Orbital-CubeSat-McGill/lora-hab-test/media/jean-mance-test.png

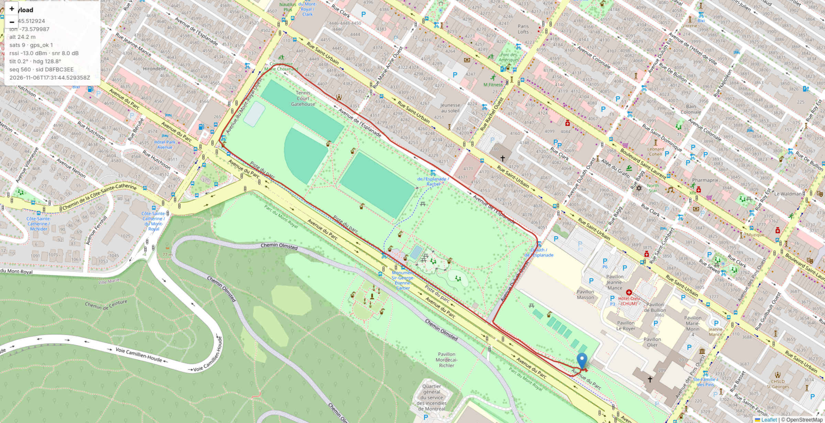
media/jean-mance-test.png
