Orbital-CubeSat-McGill/lora-hab-test/media/heltecv3-pinout.png

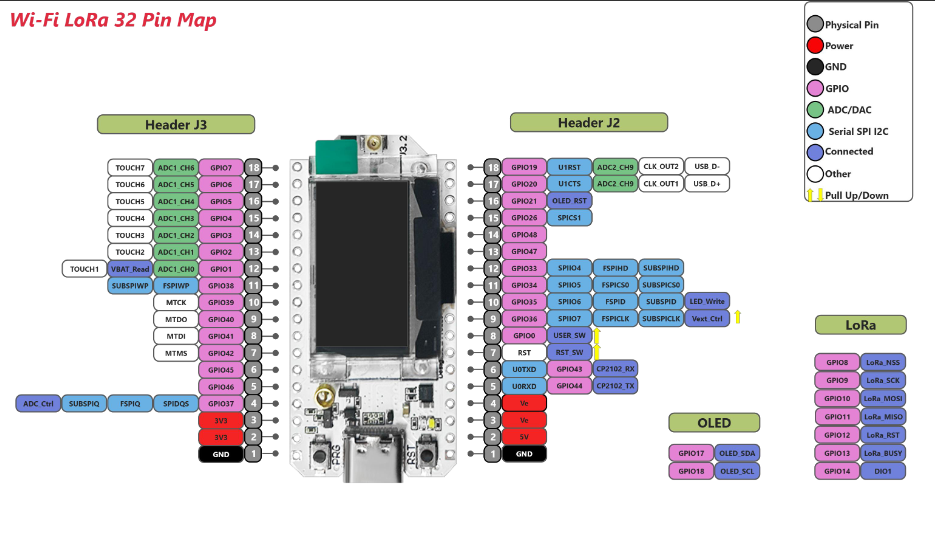
media/heltecv3-pinout.png
