Orbital-CubeSat-McGill/lora-hab-test/README.md

# LoRa High-Altitude Balloon (HAB) Link-Budget Test

Two **Heltec WiFi LoRa 32 V3** firmwares managed using PlatformIO:

- **Payload** — 1 Hz SD log + 1 Hz LoRa telemetry (TELEM); acknowledges (ACKs) ground PINGs
- **Ground** — receives TELEM, logs to csv. Ping the payload via PRG button or serial `PING`.

Default physical layer settings (PHY): **915 MHz, SF10, 125 kHz, CR 4/5, 22 dBm**. To adjust radio parameters, edit `include/radio_config.h`, and **reflash both boards**.

## Quick start

```bash
pio run -e payload -t upload
pio run -e ground -t upload

# Run while ground node is plugged into laptop. Logs received data and opens a live Leaflet map at http://127.0.0.1:8765/ (use --no-map to disable)
uv run tools/serial_logger.py <port>
```

Or `pio device monitor -e ground -b 115200` and type `PING`, but this will not log. 

## Radio knobs

In `radio_config.h`: `LORA_FREQUENCY_HZ`, `LORA_SF`, `LORA_BW_KHZ`, `LORA_CR`, `LORA_TX_POWER_DBM.` Or select a preset by uncommenting it (eg `LORA_PRESET_SF10_22`)

## Wiring for external modules

Onboard LoRa / OLED are already connected on the Heltec. External wiring only, defined in [include/pins.h.](include/pins.h) Reference [Heltec V3 pinout](media/heltecv3-pinout.png)for pinout.

| Module | Module pin | Heltec |
| --- | --- | --- |
| MPU6050  | VCC / GND | 3V3 / GND |
| MPU6050  | SDA / SCL | **GPIO 41 / 42** |
| QMC5883P | VCC / GND | 3V3 / GND |
| QMC5883P | SDA / SCL | **GPIO 41 / 42** |
| microSD  | VCC / GND | 3V3 / GND |
| microSD  | CS / SCK / MOSI / MISO | GPIO 4 / 7 / 6 / 5 |
| Neo-6M | VCC / GND | 3V3 / GND |
| Neo-6M | TX / RX | GPIO 47 / 48 (ESP RX ← GPS TX, ESP TX → GPS RX) |

External I2C is on the pin headers (41/42). Onboard OLED stays on 17/18, which are not broken out.  
I2C addresses: MPU6050 `0x98`, QMC5883P `0x2C`, OLED `0x3C`. Ground node needs no external modules.

Missing IMU/magnetometer/SD/GPS modules are handled at run-time. A warning will be displayed and csv fields will be empty. Only radio initialization is fatal. Always have an antenna connected before transmitting. 

## Libraries

Firmware (`[platformio.ini](platformio.ini)`):

- **RadioLib** — LoRa TX/RX
- **TinyGPSPlus** — Neo-6M NMEA
- **Adafruit SSD1306** (+ GFX) — OLED
- **Adafruit MPU6050** — IMU

## Logging

OTA `ver=4`: every packet header carries callsign `VA2ZMC`; TELEM/ACK also carry `seq` + `session_id` + sample; PING is header-only. A new payload folder is created each flight (power cycle). A new `logs/` folder is created every time `tools/serial_logger.py` is run. 

| Where | Folder | Files |
| --- | --- | --- |
| Payload SD | `/<utc>_<phy>_<session_id>/` | `flight.csv`, `ping.csv` |
| Laptop | `logs/<utc>_<phy>_<session_id>/` | `flight.csv`, `ping.csv`, `ground.log`, `meta.txt` |

Match runs by the shared `session_id` suffix (also a CSV column). Join rows on `session_id` + `seq`.

- Payload `flight.csv`: sensors (+ `seq` on TELEM TX)
- Payload `ping.csv`: uplink RSSI/SNR per received PING
- Ground `flight.csv`: TELEM + downlink RSSI/SNR + `gnd_lat/lon/alt`
- Ground `ping.csv`: `acked=1|0` (5s timeout ⇒ no ACK), Round-Trip Time (RTT), downlink RF

### Tracked fields

The payload logs the following data at 1 Hz:

- session_id: starts a new session each power cycle
- ts_ms: time in ms since boot
- gps_time: sample time (from GPS)
- seq: packet number on TELEM TX (blank on sample-only rows); restarts with a new session
- lat/lon/alt_m: gps data
- tilt_deg/pitch_deg/roll_deg: imu data
- heading_deg: magnetometer data
- sats: number of satellites gps has a fix on
- gps_ok: gps status
- imu_ok: imu status
- mag_ok: mag status

The payload transmits the following data at 1 Hz:

- rx_utc: time when the ground station receives the packet. 
- session_id: starts a new session each power cycle
- ts_ms: time in ms since boot
- gps_time: sample time (from GPS)
- seq: packet number, restarts with a new session
- lat/lon/alt: gps data
- tilt_deg/pitch_deg/roll_deg: imu data
- heading_deg: magnetometer data
- sats: number of satellites gps has a fix on
- gps_ok: gps status
- imu_ok: imu status
- mag_ok: mag status
- rssi_dbm: RSSI of received transmission
- snr_db: SNR of received transmission
- gnd_lat/gnd_lon/gnd_alt_m: fixed ground station coordinates

The ground station logs the following data when pinging the payload: 

- rx_utc: time when the ground station logs the ping result
- event: `ack` or `timeout`
- acked: `1` if ACK received, `0` on timeout
- session_id: payload session id (from ACK; last known on timeout)
- seq: ping sequence number
- rtt_ms: round-trip time in ms (negative waited time on 5 second timeout)
- rssi_dbm/snr_db: downlink RF of the ACK (empty on 5 second timeout)
- ts_ms/gps_time/lat/lon/alt_m/tilt_deg/pitch_deg/roll_deg/heading_deg/sats/gps_ok/imu_ok/mag_ok: sample from ACK (empty on timeout)
- gnd_lat/gnd_lon/gnd_alt_m: fixed ground station coordinates

The payload logs the following data when receiving a ping:

- ts_ms: time in ms since boot when the PING was received
- gps_time: sample time (from GPS) at PING receive
- seq: ping sequence number
- rssi_dbm: uplink RSSI of the received PING
- snr_db: uplink SNR of the received PING

### Serial logger script & live map

Logs ground USB to a new `logs/` folder and (by default) opens a Leaflet map at `http://127.0.0.1:8765/`. Type `PING` + Enter in the logger terminal, or press **PRG** on the ground board for a manual ping.

```bash
uv run tools/serial_logger.py [port] [log_dir] [flags…]
```

| Parameter | Flag / arg | Default |
| --- | --- | --- |
| Serial device (e.g. `/dev/ttyUSB0`) | `port` | auto USB/UART |
| Parent dir for session folders | `log_dir` | `logs/` |
| Serial baud | `-b` / `--baud` | `115200` |
| Host ground WGS84 (pass both or neither) | `--lat` `--lon` | unset |
| Host ground altitude (m) | `--alt` | unset |
| Disable live map | `--no-map` | off |
| Map HTTP port | `--map-port` | `8765` |
| Auto-send `PING` every `SEC` seconds (recommended for flight test) | `--ping-interval SEC` | off |

Example: `uv run tools/serial_logger.py /dev/ttyUSB0 --lat 45.5048 --lon -73.5772 --alt 40 --ping-interval 10`
