Orbital-CubeSat-McGill/lora-hab-test/media/3.7v_lipo.jpg

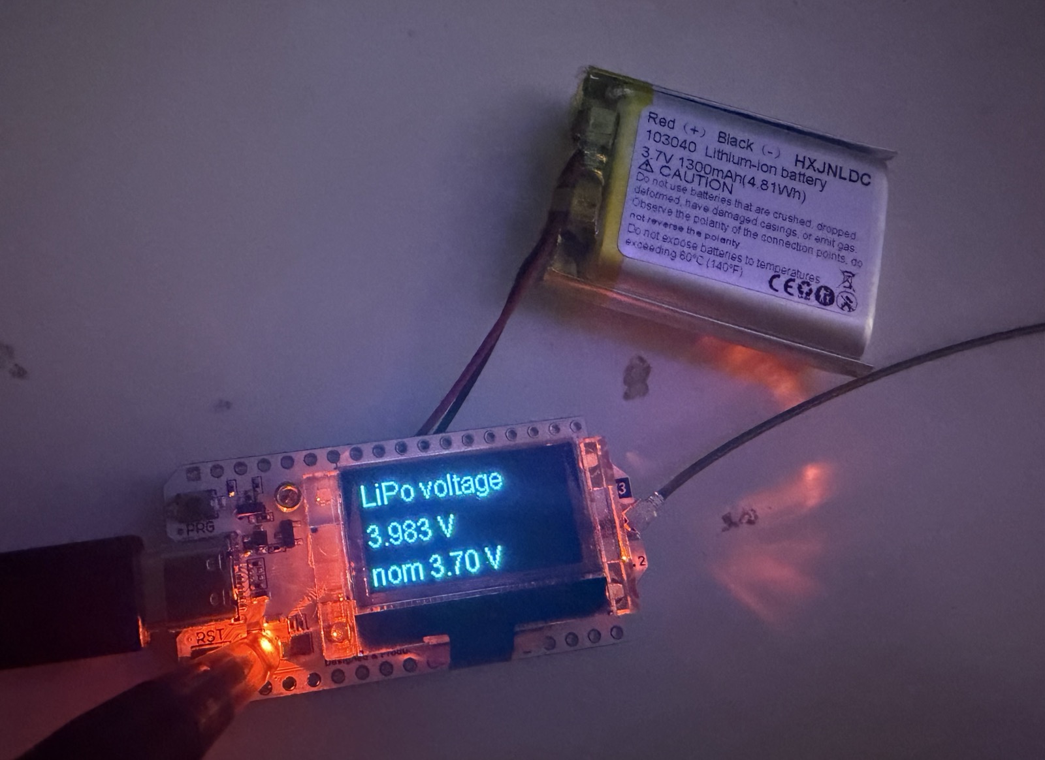
media/3.7v_lipo.jpg
