Orbital-CubeSat-McGill/lora-hab-test/media/mpu-6050.jpg

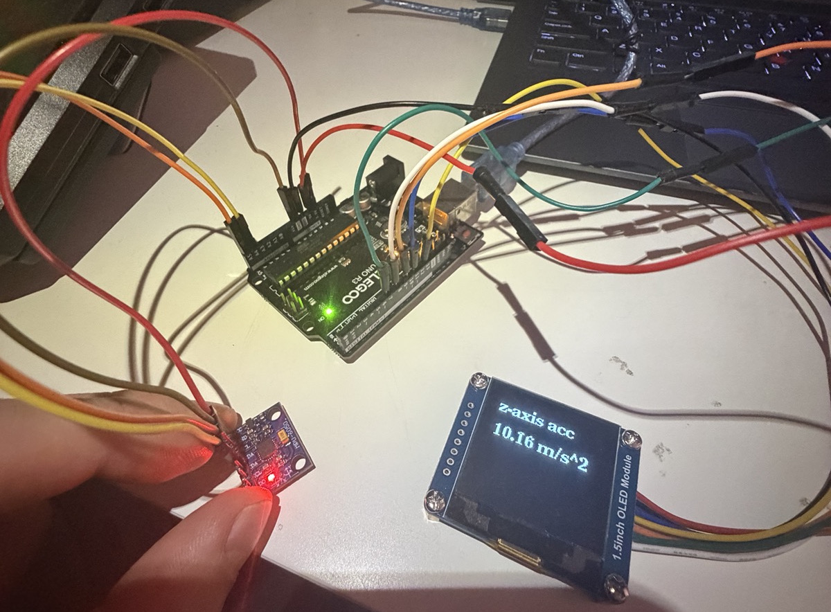
media/mpu-6050.jpg
