Orbital-CubeSat-McGill/lora-hab-test/media/neo-6m.jpg

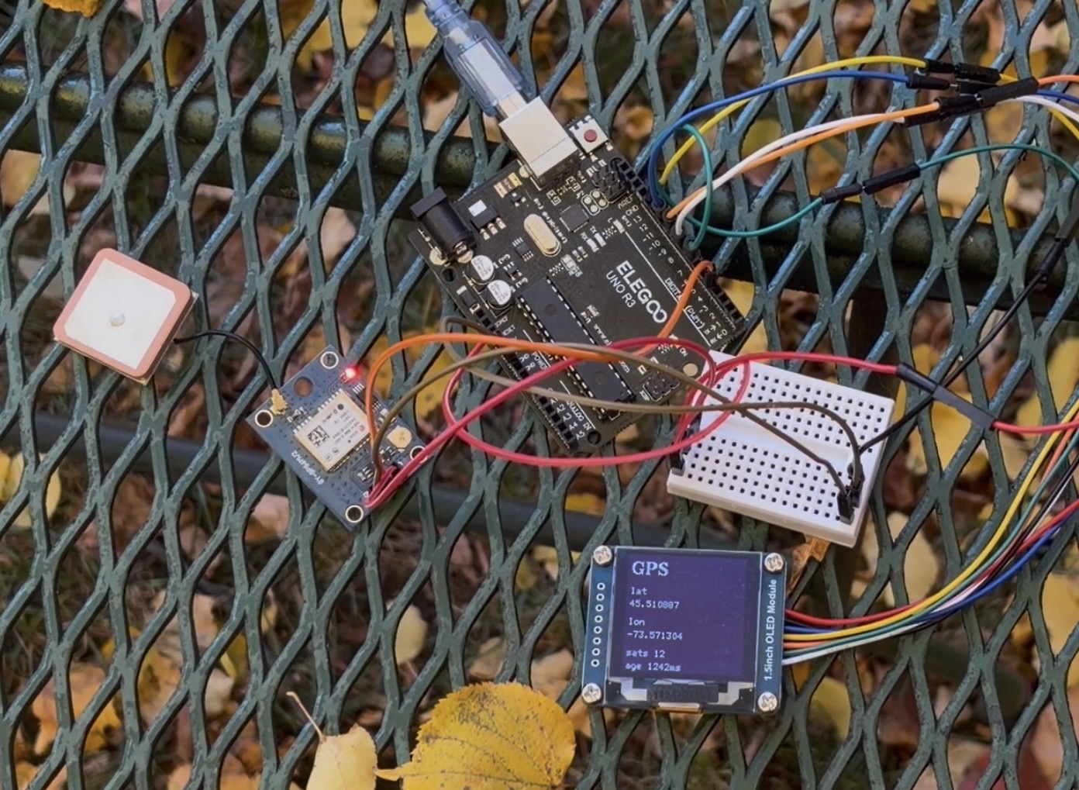
media/neo-6m.jpg
