Orbital-CubeSat-McGill/lora-hab-test/media/payload_v0.2.jpg

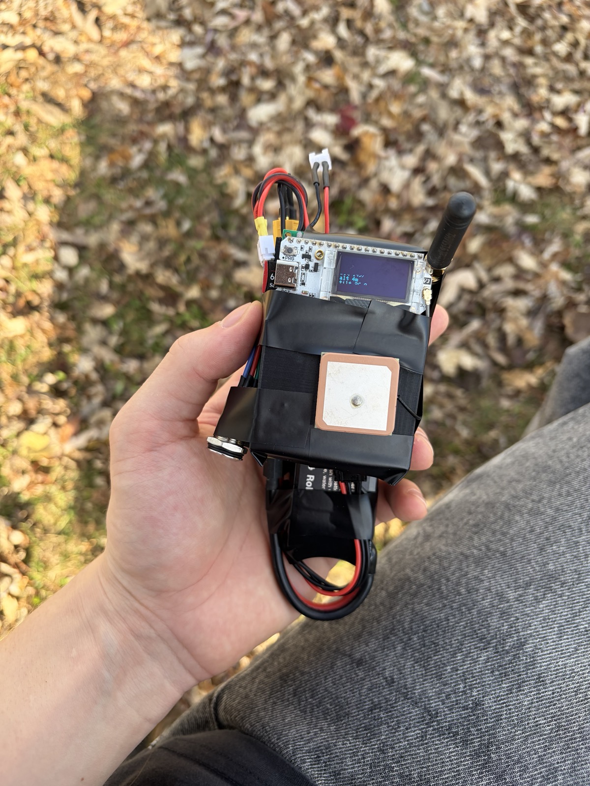
media/payload_v0.2.jpg
