Orbital-CubeSat-McGill/lora-hab-test/media/pingpong.jpg

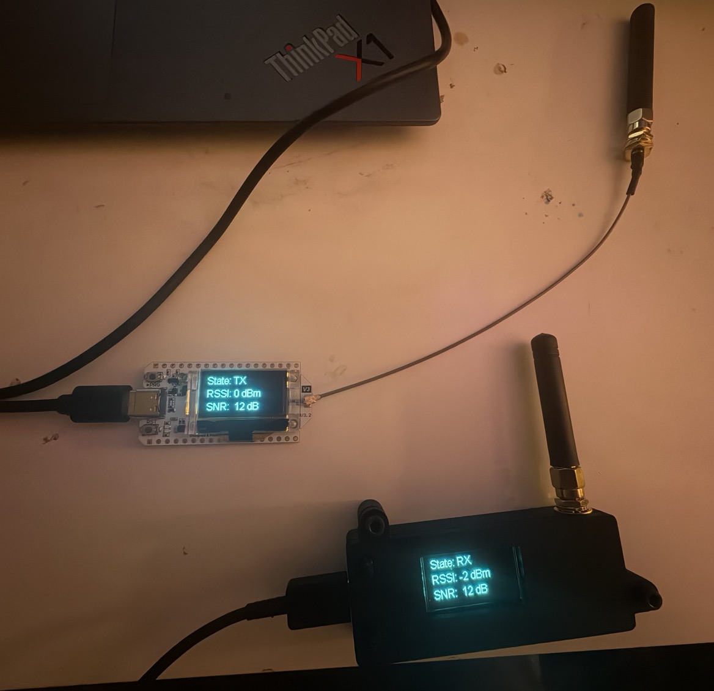
media/pingpong.jpg
