Orbital-CubeSat-McGill/lora-hab-test/media/rssi-1.png

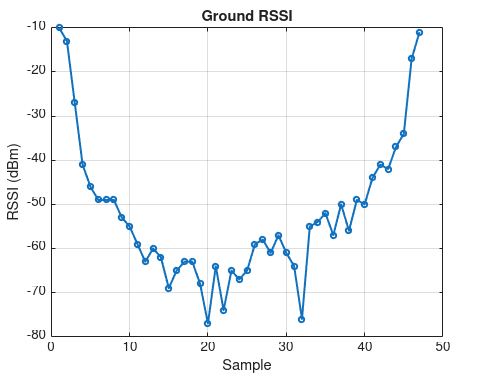
media/rssi-1.png
