Orbital-CubeSat-McGill/lora-hab-test/media/rtt-vs-rssi-1.png

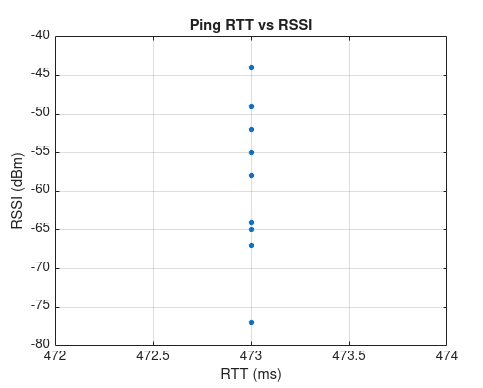
media/rtt-vs-rssi-1.png
