Orbital-CubeSat-McGill/lora-hab-test/media/snr-1.png

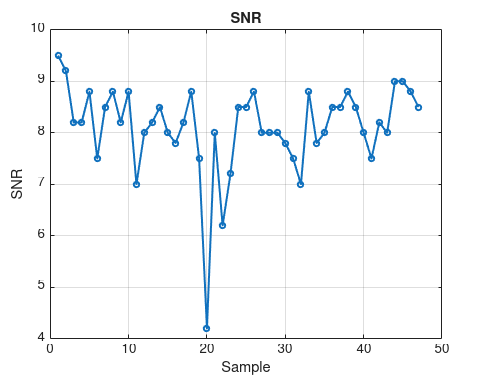
media/snr-1.png
