Orbital-CubeSat-McGill/lora-hab-test/media/yagi.jpg

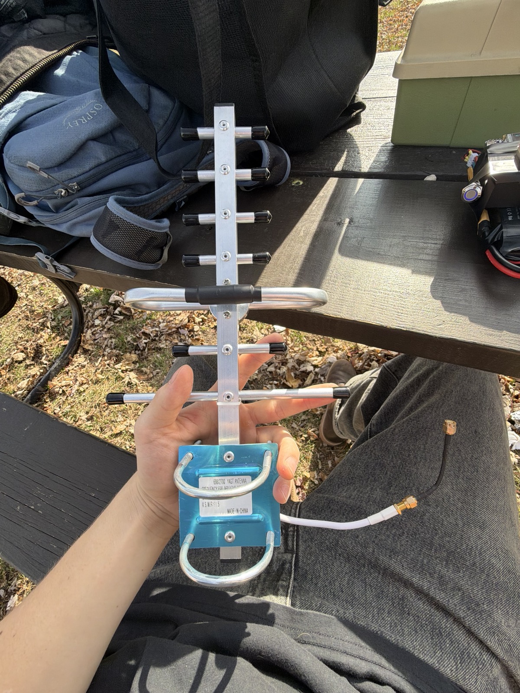
media/yagi.jpg
