Orbital-CubeSat-McGill/lora-hab-test/cad/lorahab-enclosure-v1.0.stl

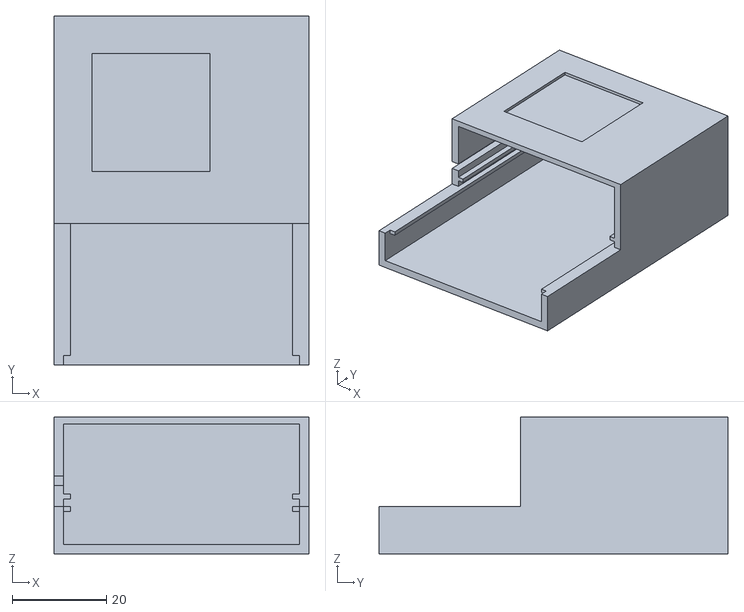
[picture p12: CAD file, 2026-11-06]
cad/lorahab-enclosure-v1.0.stl
54.0 x 74.0 x 29.0
