Orbital-CubeSat-McGill/lora-hab-test/media/alt-test-1.png

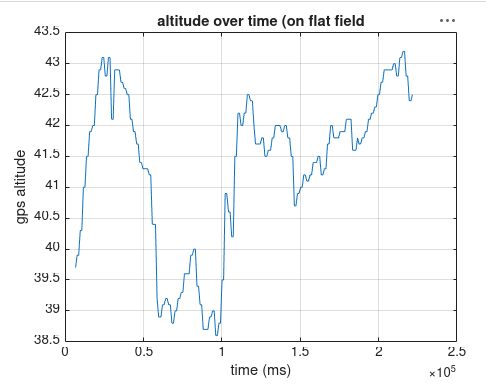
media/alt-test-1.png
