Orbital-CubeSat-McGill/lora-hab-test/media/rutherford-test.png

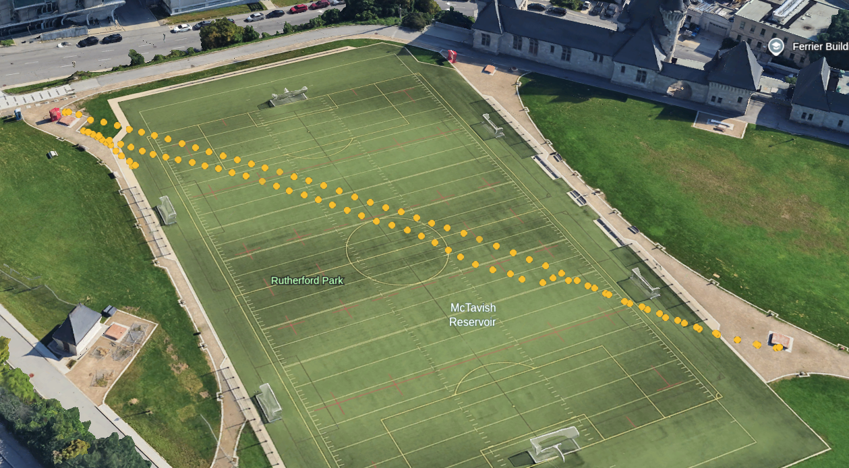
media/rutherford-test.png
