Orbital-CubeSat-McGill/lora-hab-test/src/ground/main.cpp

#include <Arduino.h>
#include <Adafruit_SSD1306.h>
#include <RadioLib.h>
#include <Wire.h>

#include "hab_display.h"
#include "hab_packet.h"
#include "hab_radio.h"
#include "pins.h"
#include "radio_config.h"

static SX1262 radio = new Module(PIN_LORA_NSS, PIN_LORA_DIO1, PIN_LORA_RST,
                                 PIN_LORA_BUSY);
static Adafruit_SSD1306 display(128, 64, &Wire, -1);

static volatile bool g_rxFlag = false;

static uint16_t g_pingSeq = 0;
static bool     g_pingWaiting = false;
static uint32_t g_pingSentMs = 0;
static uint16_t g_pingExpectSeq = 0;

// Last completed ping result for OLED (idle until first PING).
enum PingUi : uint8_t { PING_UI_NONE = 0, PING_UI_WAIT, PING_UI_ACK, PING_UI_NOACK };
static PingUi   g_pingUi = PING_UI_NONE;
static uint16_t g_pingUiSeq = 0;
static int32_t  g_pingUiRttMs = -1;

static float    g_lastRssi = 0;
static float    g_lastSnr  = 0;
static uint16_t g_lastSeq  = 0;
static int32_t  g_lastAltMm = 0;
static uint32_t g_lastRxMs  = 0;
static bool     g_havePacket = false;
static uint32_t g_lastSessionId = 0;  // from TELEM/ACK; used on ping timeout CSV

static String g_serialLine;

static void IRAM_ATTR onRadioRx() { g_rxFlag = true; }

static void armReceive() {
  g_rxFlag = false;
  radio.startReceive();
}

static void utcNow(char* buf, size_t cap) {
  // No RTC: use millis-based placeholder; host logger stamps wall clock.
  snprintf(buf, cap, "t+%lu", (unsigned long)millis());
}

static void updateOled() {
  display.clearDisplay();
  uint8_t row = 0;
  habOledRow(display, row++);
  display.print(F("GROUND"));
  habOledRow(display, row++);
  display.printf("SF%d %ddBm", LORA_SF, LORA_TX_POWER_DBM);
  if (!g_havePacket) {
    habOledRow(display, row++);
    display.print(F("waiting..."));
    habOledRow(display, row++);
    display.print(F("BTN/USB: PING"));
  } else {
    habOledRow(display, row++);
    display.printf("RSSI %.0f SNR %.1f", g_lastRssi, g_lastSnr);
    habOledRow(display, row++);
    display.printf("seq %u", g_lastSeq);
    habOledRow(display, row++);
    display.printf("alt %.0fm", g_lastAltMm / 1000.0);
    const uint32_t age = (millis() - g_lastRxMs) / 1000UL;
    habOledRow(display, row++);
    display.printf("age %lus", (unsigned long)age);
  }

  habOledRow(display, row++);
  switch (g_pingUi) {
    case PING_UI_WAIT:
      display.printf("PING #%u ...", g_pingUiSeq);
      break;
    case PING_UI_ACK:
      if (g_pingUiRttMs >= 0) {
        display.printf("ACK #%u %ldms", g_pingUiSeq, (long)g_pingUiRttMs);
      } else {
        display.printf("ACK #%u", g_pingUiSeq);
      }
      break;
    case PING_UI_NOACK:
      display.printf("NO-ACK #%u", g_pingUiSeq);
      break;
    default:
      display.print(F("ping: --"));
      break;
  }
  display.display();
}

static void sendPing() {
  HabPacket pkt = {};
  pkt.type       = HAB_PKT_PING;
  pkt.seq        = ++g_pingSeq;
  pkt.session_id = 0;  // payload fills session_id on ACK
  habSampleClear(pkt.sample);

  uint8_t buf[HAB_PKT_MAX_LEN];
  size_t n = habPacketEncode(pkt, buf, sizeof(buf));
  int state = radio.transmit(buf, n);
  armReceive();

  if (state != RADIOLIB_ERR_NONE) {
    Serial.printf("[ground] PING TX failed (%d)\n", state);
    return;
  }

  g_pingWaiting   = true;
  g_pingSentMs    = millis();
  g_pingExpectSeq = pkt.seq;
  g_pingUi        = PING_UI_WAIT;
  g_pingUiSeq     = pkt.seq;
  g_pingUiRttMs   = -1;
  Serial.printf("[ground] PING seq=%u\n", pkt.seq);
  updateOled();
}

static void onDecoded(const HabPacket& pkt, float rssi, float snr) {
  g_lastRssi   = rssi;
  g_lastSnr    = snr;
  g_lastSeq    = pkt.seq;
  g_lastAltMm  = pkt.sample.alt_mm;
  g_lastRxMs   = millis();
  g_havePacket = true;
  if (pkt.session_id != 0) {
    g_lastSessionId = pkt.session_id;
  }

  char utc[24];
  utcNow(utc, sizeof(utc));

  if (pkt.type == HAB_PKT_TELEM) {
    habPrettyPrintTelem(Serial, pkt, rssi, snr);
    habCsvLineGroundFlight(Serial, pkt, rssi, snr, utc);
  } else if (pkt.type == HAB_PKT_ACK) {
    int32_t rtt = -1;
    if (g_pingWaiting && pkt.seq == g_pingExpectSeq) {
      rtt = (int32_t)(millis() - g_pingSentMs);
      g_pingWaiting = false;
      g_pingUi      = PING_UI_ACK;
      g_pingUiSeq   = pkt.seq;
      g_pingUiRttMs = rtt;
    }
    habPrettyPrintAck(Serial, pkt, rssi, snr, rtt);
    habCsvLineGroundPingAck(Serial, pkt, rssi, snr, utc, rtt);
  }

  updateOled();
}

static void serviceRx() {
  if (!g_rxFlag) {
    return;
  }
  g_rxFlag = false;

  uint8_t buf[HAB_PKT_MAX_LEN];
  int state = radio.readData(buf, sizeof(buf));
  if (state == RADIOLIB_ERR_NONE) {
    size_t len = radio.getPacketLength();
    float rssi = radio.getRSSI();
    float snr  = radio.getSNR();
    HabPacket pkt;
    if (habPacketDecode(buf, len, pkt)) {
      onDecoded(pkt, rssi, snr);
    } else {
      Serial.printf("[ground] ignore bad pkt len=%u\n", (unsigned)len);
    }
  }
  armReceive();
}

static void pollButton() {
  static bool last = true;  // pulled up, idle HIGH
  static uint32_t lastChange = 0;
  bool now = digitalRead(PIN_PRG_BTN);
  if (now != last && (millis() - lastChange) > 40) {
    lastChange = millis();
    last = now;
    if (now == LOW && !g_pingWaiting) {
      sendPing();
    }
  }
}

static void pollSerialCmd() {
  while (Serial.available()) {
    char c = (char)Serial.read();
    if (c == '\n' || c == '\r') {
      g_serialLine.trim();
      if (g_serialLine.equalsIgnoreCase("PING") && !g_pingWaiting) {
        sendPing();
      }
      g_serialLine = "";
    } else if (g_serialLine.length() < 32) {
      g_serialLine += c;
    }
  }
}

void setup() {
  Serial.begin(115200);
  delay(500);
  Serial.println(F("\n=== HAB Ground ==="));
  Serial.println(F("Laptop test: log USB serial with:"));
  Serial.println(F("  uv run tools/serial_logger.py /dev/ttyUSB0 --lat LAT --lon LON"));
  Serial.println(F("Files: logs/<utc>_<phy>_<session_id>/ …"));
  habRadioPrintConfig(Serial);
  habCsvHeaderGroundFlight(Serial);
  habCsvHeaderGroundPing(Serial);
  Serial.println(F("Commands: type PING + Enter, or press PRG button"));

  pinMode(PIN_PRG_BTN, INPUT_PULLUP);

  bool dispOk = habDisplayBegin(display);
  if (!dispOk) {
    Serial.println(F("[ground] WARN: OLED init failed"));
  }

  int st = habRadioBegin(radio);
  bool radioOk = (st == RADIOLIB_ERR_NONE);
  if (!radioOk) {
    Serial.printf("[ground] FATAL: radio init failed (%d)\n", st);
    if (dispOk) {
      habDisplaySplash(display, "GROUND", false);
    }
    while (true) {
      delay(1000);
    }
  }
  Serial.println(F("[ground] Radio OK"));

  radio.setPacketReceivedAction(onRadioRx);

  if (dispOk) {
    habDisplaySplash(display, "GROUND", true);
    updateOled();
  }

  armReceive();
  Serial.println(F("[ground] Listening"));
}

void loop() {
  serviceRx();
  pollButton();
  pollSerialCmd();

  if (g_pingWaiting && (millis() - g_pingSentMs) > HAB_PING_TIMEOUT_MS) {
    const uint16_t seq = g_pingExpectSeq;
    const uint32_t waited = millis() - g_pingSentMs;
    g_pingWaiting = false;
    g_pingUi      = PING_UI_NOACK;
    g_pingUiSeq   = seq;
    g_pingUiRttMs = -1;
    Serial.printf("[ground] PING seq=%u NO-ACK (timeout)\n", seq);
    habPrettyPrintPingTimeout(Serial, seq, waited);
    char utc[24];
    utcNow(utc, sizeof(utc));
    habCsvLineGroundPingTimeout(Serial, seq, g_lastSessionId, utc,
                                HAB_PING_TIMEOUT_MS);
    updateOled();
  }

  static uint32_t lastOled = 0;
  if (millis() - lastOled > 500) {
    lastOled = millis();
    updateOled();
  }
}
