Orbital-CubeSat-McGill/lora-hab-test/(commit log)

2026-10-29 git repo migration
    [flight.csv, geojson_track.csv, ground_20261029_182204.csv, ground_20261029_182603.csv, lat_lon_alt.csv, ping.csv]
2026-10-29 improve telemetry packet formatting and session directory naming. Updated PING timeout messages for the no-ack case, added PHY configuration details to logs.
2026-10-29 payload now logs and tx at 1hz
2026-10-30 changed external i2c pins to gpio 41/42
2026-11-01 battery % shows -1 when no lipo conected
2026-11-06 payload enclosure
    [lorahab-enclosure-v1.0.stl]
2026-11-06 removed battery percentage
2026-11-08 FLIGHT nov 8 data
    [flight.csv, ping.csv]
2026-11-08 payoad data
    [flight.csv, ping.csv]
2026-11-08 tkstar data
    [TK905-4G-71916-History+route+details.xls]
